Ruslastor/Car-Sharing-GPS-tracking-system/images/battery.png

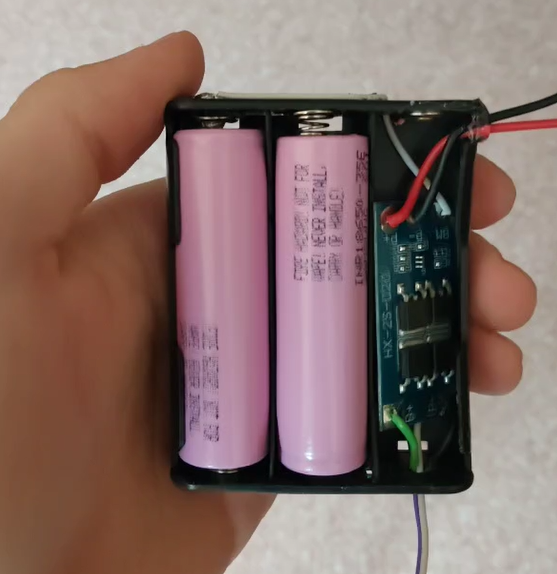
images/battery.png
