Ruslastor/Car-Sharing-GPS-tracking-system/images/competition.jpg

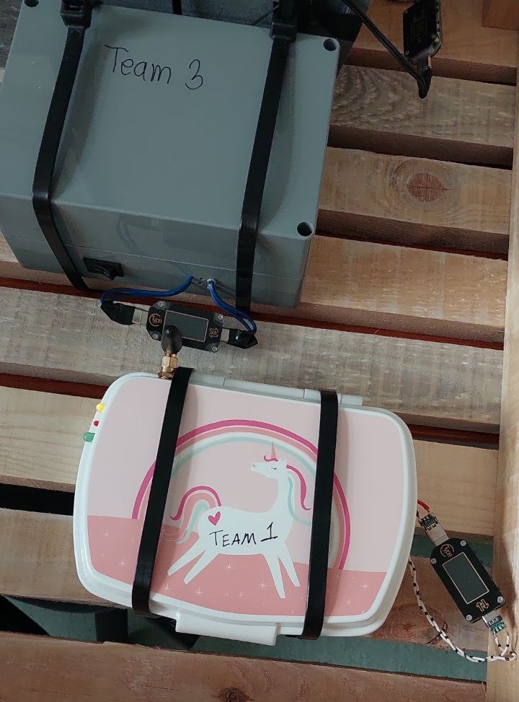
images/competition.jpg
